yangwei251003/active-inspection/mechanical/CAD_BRIEF.md

# 主动巡检终端 · 机械设计 brief

状态：2026-09-30，采购前可复验设计，未实物试装。单位 mm。模型不用于承重、安全防护或防水认证。

- 新装配：桌面工具风格，深灰底座、浅灰盖、黑色摄像头面罩。180 × 130 × 55 底座，模块化可拆维护。
- 坐标：底座底面中心为原点，XY 为桌面，+Z 向上；正面在 -Y。所有打印零件独立导出，摆放原点在打印底面。
- 壁厚 2.4，底厚 2.4，盖厚 3.0，外圆角 R10；M3 通孔 3.4；螺母窝对边 5.8，装配滑动余量每边 0.35。
- 底座四角螺丝柱，顶盖四颗 M3 × 10 + M3 螺母关闭；不使用热熔铜螺母，不需烙铁。
- 电子托盘 152 × 104，绑带长槽、每板 4 个且合计 8 个 12 mm 高独立 PCB 支脚；NUCLEO 与 P4 并排。板卡孔位不作为已核验设计输入。
- 背部 90 × 18 开口可穿预制 USB/DC 线和舵机可拔电源线，内部绑带孔负责应力释放；背部另有独立舵机服务开口。电气接头选型由硬件清单决定。
- 顶部通用云台托板有可调长槽、绑带槽和排线口。FIT0415 的固定孔位未取得可信尺寸图，因此不会伪造固定孔阵列。
- 摄像头罩用开口后盖、短柱、可调绑带固定 25 × 24 / 32 × 32 摄像板包络；视窗直径 22。镜头轴和传感器板对中需实物核验。
- 支架几何用标注的 55 × 45 × 65 采购件空间包络，不是 FIT0415 的官方 STEP。支架不在打印 BOM。
- 主装配仅安装 1 个线束锚点：15 个打印实体 + 5 个采购参考包络 = 20 个实体。打印清单的第 2 个锚点明确是备用件，不在装配中；打印清单按 15 安装 + 1 备用共 16 件，可选配合试样另计。
- 排线穿顶盖后在头部后方形成宽松 C 环；初次动作仅 ±30° 水平、±15° 俯仰，手动确认无拉扯后再扩大。不得以软件允许角度当作机械通过证据。

## 输入证据与缺口

已检索 step-parts 能力：当前会话未提供；同一 routeId 能力搜索未返回候选。官方板卡资源提供尺寸图/设计文件，但未取得可直接复用的精确 STEP。本次不使用未经核对的社区 STEP。

1. [ST NUCLEO-F401RE 官方资源页](https://www.st.com/en/evaluation-tools/nucleo-f401re.html)：MB1136/UM1724；本模型仅采用 70 × 82.5 × 24 包络，孔位待到货核验。
2. [Waveshare P4-NANO 官方资源](https://docs.waveshare.com/ESP32-P4-NANO/Resources-And-Documents)：尺寸图；本模型采用 85 × 56 × 25 包络，孔位/端口高度未核验。
3. [DFRobot FIT0415](https://www.dfrobot.com/product-1271.html) 与[中文页](https://www.dfrobot.com.cn/exchange-id1117.html)：9–12 g 舵机；组装后高 65。底面包络和安装孔待核验。原厂要求裁剪舵盘，采购应优先卖家预装版本；切勿把裸套件当成完全即插即用。
4. [Waveshare 摄像头系列表](https://www.waveshare.com/rpi-camera.htm)：OV5647 有 25 × 24 与 32 × 32 等不同板型，不能仅按传感器名锁定尺寸。圆孔直径与镜头离面距离待选定 SKU 后验证。

## 输出及验收

- `models/*.step.py`：参数化源；对应 STEP 为主 CAD 交付；`stl/` 是单件打印副本。
- 关闭实体、每件正体积、命名装配；验证外形、底/盖配合、托盘净空和预设采购件包络间隙。
- 对主装配、拆解视图和全部打印件执行 CAD 快照并检查。
- 实板连接器、走线、热、信号完整性、舵机力矩/回差、FFC 疲劳、3D 打印公差和试装均属待实测。
