yangwei251003/active-inspection/mechanical/VISUAL_REVIEW.md

# CAD 快照审看记录

2026-09-30，由负责机械交付的 Codex 子代理实际打开以下 PNG 审看。使用 CAD `scripts/snapshot` 的工程几何输出；没有把图片生成器的概念图作为验证证据。图中矩形电路板、舵机/支架和圆柱镜头是明确标注的采购件参考包络，不能按它们的形状购买、打印或当作已核验实物模型。

| 已审看的文件组（位于 `previews/`） | 实际观察与对应检查 |
|---|---|
| `inspection_terminal_0/1/2/3_20260930T021804Z.png` | 修复后的主装配等轴、背底等轴、顶、前四视图。底盖轮廓对齐，四角孔和顶板布置正常；背后穿线口/底面孔可见，机头朝 -Y。三处接触面由 `check_interfaces.py` 的 0 位移检查支持；主包围盒 180×130×139 mm |
| `exploded_terminal_0_20260930T021804Z.png` | 可看到底座、托盘、两板参考包络、盖和机头的分层关系。爆炸间距是说明性展开，不作为紧固顺序或动态运动证明 |
| `base_shell_0_20260930T020549Z.png` | 腔体、侧通风、背部大窗口、螺母侧槽存在；底座单一实体。大窗口/侧槽的打印支撑待服务商切片确认。后续机头螺柱修复未改变底座几何 |
| `lid_0_20260930T020549Z.png` | 定位环朝上，四角避柱缺口存在；该独立导出已翻为打印朝向，不再手动翻面。后续机头螺柱修复未改变盖几何 |
| `electronics_tray_0_20260930T021423Z.png` | 绑带/轻量化槽、四个固定孔可见，实体连续 |
| `gantry_adapter_0_20260930T021423Z.png` | 纵横长槽和四个底板孔可见，未假定未经核验的 FIT0415 孔距 |
| `camera_shell_0_20260930T021423Z.png` | 四角螺柱向外移后内腔可见，开口未被意外封闭；以实体布尔检查确认 32 mm 板投影加每边 0.4 mm 的区域不与螺柱相交 |
| `camera_back_0_20260930T021423Z.png` | 长槽形成有上部连接桥的安装区域，内横槽保留桥接，未出现悬空小岛；STEP 单实体和 STL 单连通检查支持这一观察 |
| `pcb_foot_0_20260930T021423Z.png` | 12 mm 支脚及中心孔存在，打印底面平整 |
| `cable_anchor_0_20260930T021423Z.png` | 两个绑带槽和中部凸台存在，仍须按线束实物位置粘贴 |
| `fit_coupon_0_20260930T021423Z.png` | 三档圆孔与六角窝可辨，几何尺寸已由对应 STEP facts 及源码参数记录；实际配合待打印 |

审图发现并修复：原机头四角螺柱会挤占最大 32 mm 板的角部。修复前实体相交体积 76.1435 mm³，修复后 0。相机罩/后盖和两份装配 STEP 已重生成，主装配也重新拍摄并审看，未沿用旧主图作为修复后证据。

仍不能由快照判断的事项：具体镜头安装深度、真实 PCB 插头和焊点、FFC 松弛长度/疲劳、实际舵盘连接、云台全行程碰撞、塑料强度、温升、打印公差和孔配合。首测角窗仅为 60–120° / 75–105° 的计划；实际观测记录留在 `fit_check.csv`，未伪填数据。
