yangwei251003/active-inspection/hardware/docs/01-procurement.md

# 模块与器件参考

公开版只保留技术BOM、模块方案和引脚规划，不附个人采购记录、金额、供应商对话或订单。

请查看相邻硬件入口、`../bom.csv`、`../pin-plan.json` 和 `../eda/`。板卡实际修订、接头/线束、供电和机械接口均须结合到货实物核对。本次未采购、接线或烧录，模块图不是制造放行结论。
