yangwei251003/active-inspection/PROVENANCE.md

# 来源与公开范围

来自维护者巡点本地工程。保留自有应用/服务/模拟器/测试、控制与协处理器集成源、参数化机械设计和模块互连设计。原项目截图均明确为模拟来源或模块设计，不冒充实物效果。

本次只在公开副本中整理：将ST依赖清单独立公开、补固定来源获取器、将ESP构建入口改为标准IDF环境调用，泛化本机路径。没有修改原活动服务、SDK、工程或实物，也没有推进新硬件设计。

## 未公开

- SDK、组件/工具缓存、node_modules、编译输出、GLTF生成缓存、备份和运行日志。
- 当前 `sdkconfig`、真实服务配置、`.env`、Wi-Fi、密码、设备令牌与私有数据目录。
- 个人预算/询价、事件账本、原始状态、真实部署数据和历史媒体工具产物。
- 官方EDA对照项目及其他厂商参考材料；这些不是独立原创项目。

技术BOM剔除了估算价格字段。SDK与C6官方从机不计作本项目原创代码。由于开发中和上述公开边界，不能据本仓库宣称整个原本地文件夹均已托管或可删除。

最终文档复查额外排除厂商参考 PDF/裁图及个人采购金额；修复旧机器浏览链接，并把可选 Playwright/CAD 工具入口改为通用依赖或明确环境变量。原工程历史检查说明不作为本次实测证据。
