yangwei251003/active-inspection/mechanical/fit_check.csv

检查ID | 检查对象 | 设计值或判据 | 实测值 | 单位 | 结果 | 照片或日志路径 | 备注
M01 | NUCLEO板卡含接头包络 | 不超70×82.5×24 |  | mm | 待测 |  | 先确认型号和板版本
M02 | P4板卡含接头包络 | 不超56×85×25 |  | mm | 待测 |  | 先确认型号和板版本
M03 | 相机PCB和镜头中心 | 所选SKU可放入罩内且镜头对中 |  | mm | 待测 |  | 不得只按OV5647传感器名确认尺寸
M04 | 成品云台采购状态 | 两舵机和匹配舵盘已装好且无需裁剪 |  |  | 待测 |  | 裸FIT0415不满足本项
M05 | M3配合试样中间通孔 | 标称3.4且螺丝可手放入 |  | mm | 待测 |  | 不要整件缩放
M06 | M3配合试样中间六角窝 | 标称对边5.8且螺母可平放 |  | mm | 待测 |  | 本试样不代表侧装槽已通过
M07 | 底座侧装螺母槽 | 4处螺母能进入定位且无明显摇晃 |  |  | 待测 |  | 手动检验
M08 | 上盖定位环 | 每边设计余量0.35且无强压装配 |  | mm | 待测 |  | 记录打印材料和切片参数
M09 | 底部螺丝头离桌面 | 至少1 |  | mm | 待测 |  | 5mm脚垫名义值仍须按螺丝头实测
M10 | 托盘螺丝方向 | 从底座外底面向上穿入且顶端不触板 |  |  | 待测 |  | 4处分别确认
M11 | 两块板卡固定 | 轻摇不移位且绑带不压器件和插座 |  |  | 待测 |  | 支脚位置按板底避空区布置
M12 | 板上器件线材与上盖 | 不接触或挤压且有可见余量 |  | mm | 待测 |  | 设计板包络到盖平面最小4.2
M13 | USB和电源线应力释放 | 轻拉外皮时板卡插座不移动 |  |  | 待测 |  | 不得拉FFC或裸端子
M14 | 中位镜头画面 | 四角无罩体遮挡且画面可用 |  |  | 待测 |  | 保存90/90画面
M15 | 水平60俯仰75 | 无碰撞拉扯遮挡和异常声音 |  |  | 待测 |  | 仅在电气核验和限角配置完成后点动
M16 | 水平60俯仰105 | 无碰撞拉扯遮挡和异常声音 |  |  | 待测 |  | 同上
M17 | 水平120俯仰75 | 无碰撞拉扯遮挡和异常声音 |  |  | 待测 |  | 同上
M18 | 水平120俯仰105 | 无碰撞拉扯遮挡和异常声音 |  |  | 待测 |  | 同上
M19 | 限角窗内重复巡检 | 线缆无磨损松脱且视点可重复 |  |  | 待测 |  | 记录次数和画面偏移
M20 | 封闭运行温升 | 记录环境与壳内温度及复位抖动 |  |  | 待测 |  | 无实测前不填写通过
