yangwei251003/active-inspection/docs/images/mobile-points.png

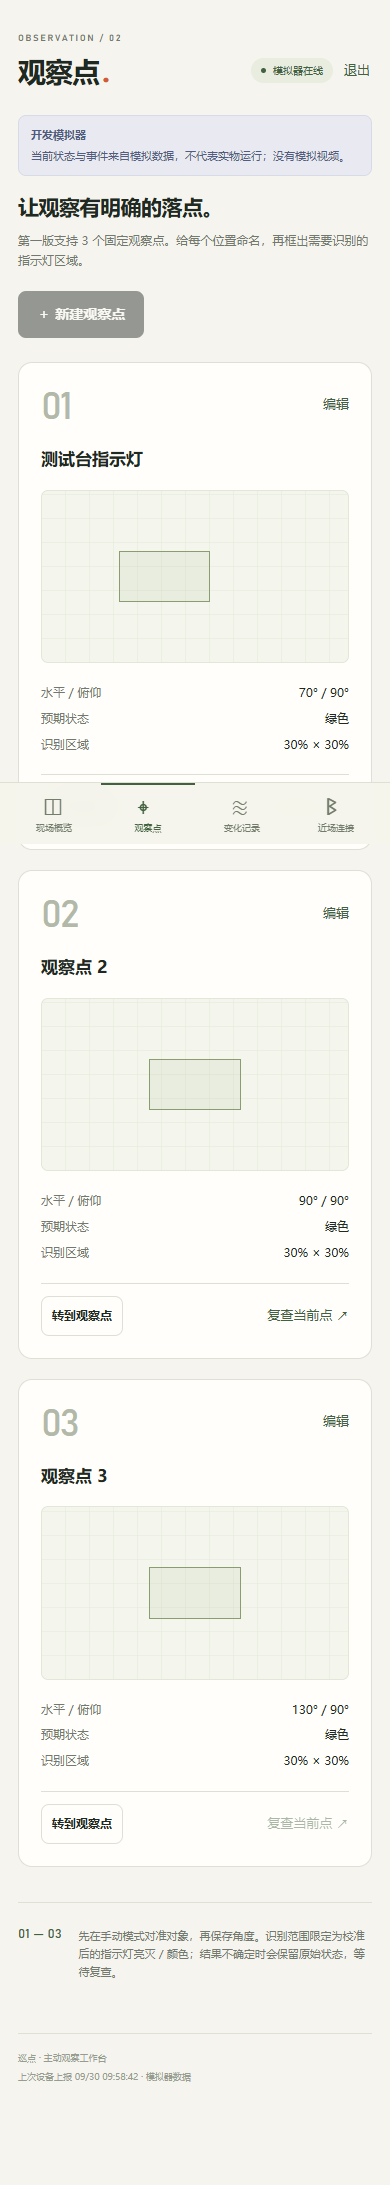
docs/images/mobile-points.png
