yangwei251003/active-inspection/hardware/eda/module-interconnect.png

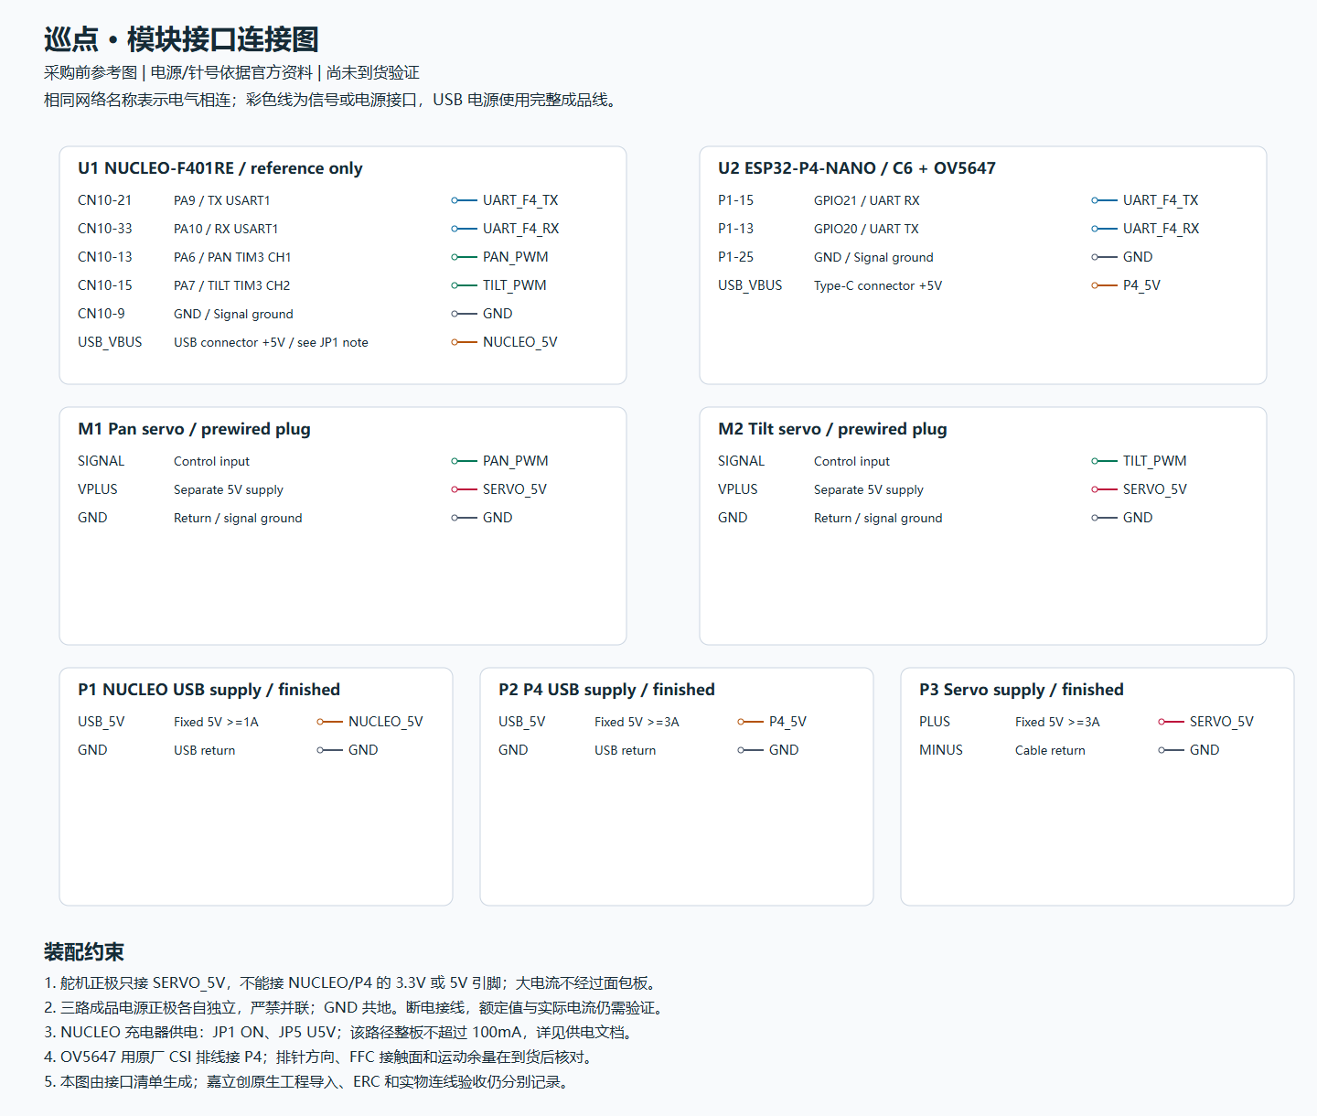
hardware/eda/module-interconnect.png
