yangwei251003/active-inspection/mechanical/previews/base_shell_0_20260930T020549Z.png

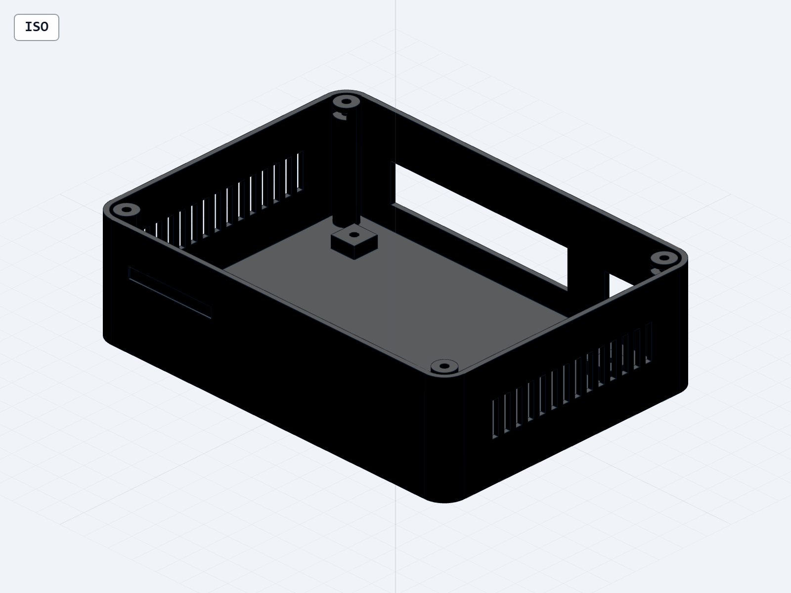
mechanical/previews/base_shell_0_20260930T020549Z.png
