yangwei251003/active-inspection/mechanical/previews/cable_anchor_0_20260930T021423Z.png

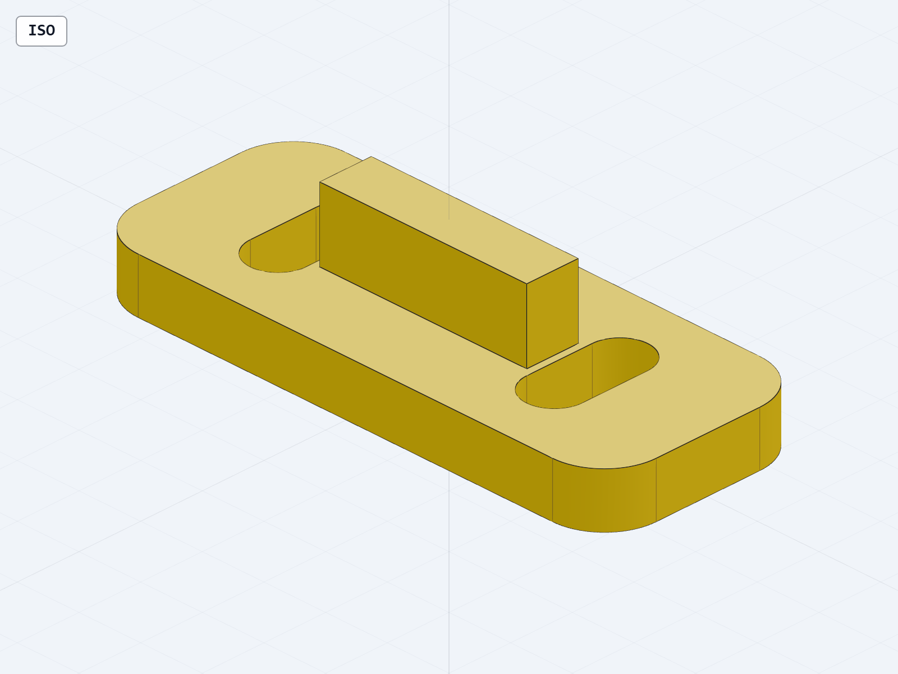
mechanical/previews/cable_anchor_0_20260930T021423Z.png
