yangwei251003/active-inspection/mechanical/previews/camera_shell_0_20260930T021423Z.png

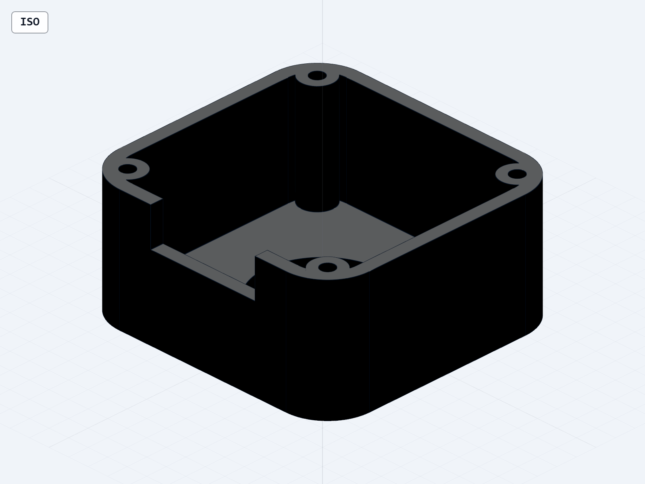
mechanical/previews/camera_shell_0_20260930T021423Z.png
