yangwei251003/active-inspection/mechanical/previews/electronics_tray_0_20260930T021423Z.png

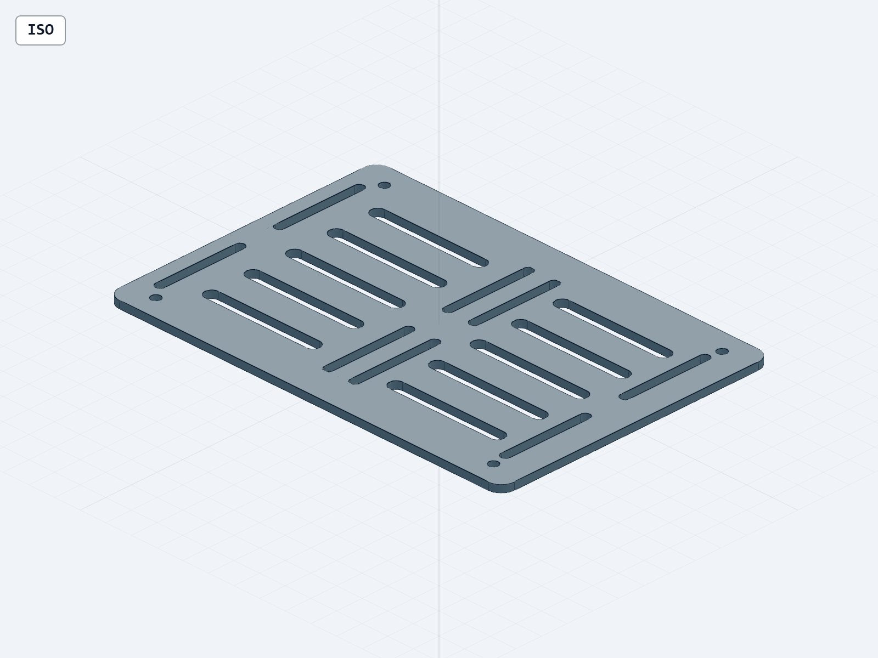
mechanical/previews/electronics_tray_0_20260930T021423Z.png
