yangwei251003/active-inspection/mechanical/previews/exploded_terminal_0_20260930T020549Z.png

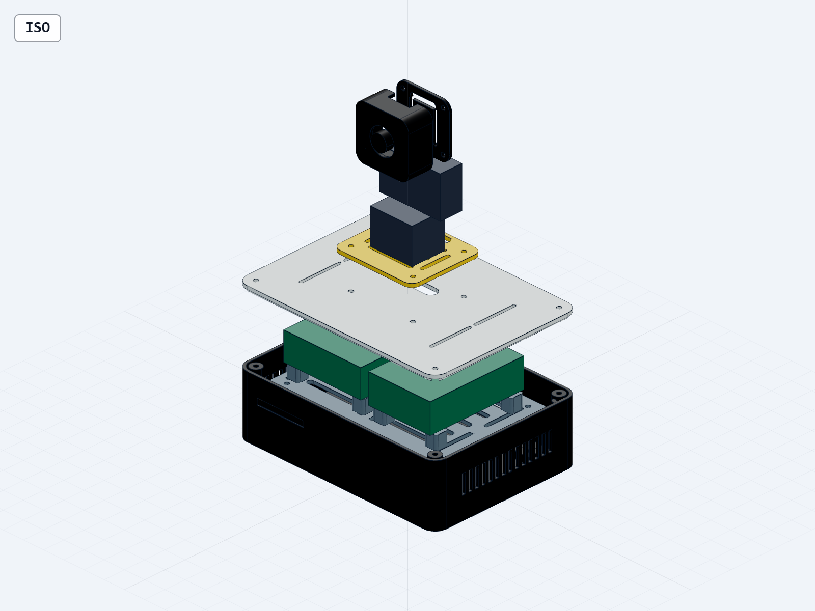
mechanical/previews/exploded_terminal_0_20260930T020549Z.png
