yangwei251003/active-inspection/mechanical/previews/fit_coupon_0_20260930T021423Z.png

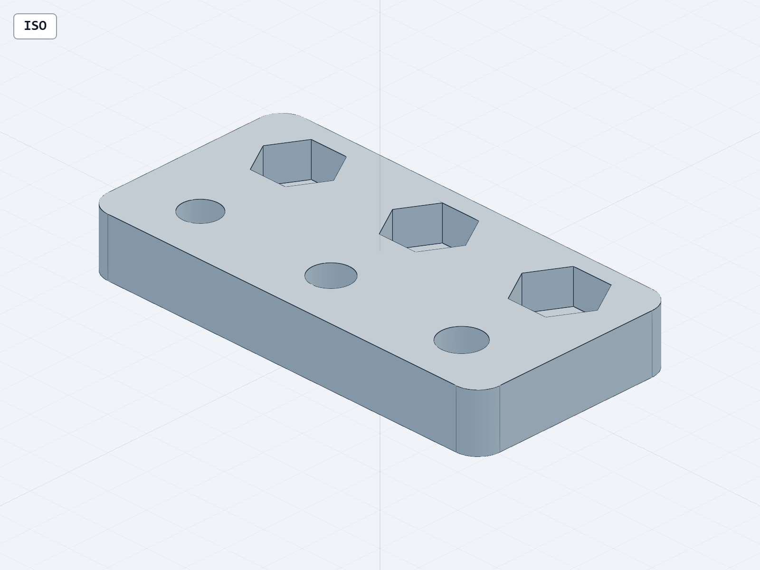
mechanical/previews/fit_coupon_0_20260930T021423Z.png
