yangwei251003/active-inspection/mechanical/previews/initial_iso_20260930T014438Z.png

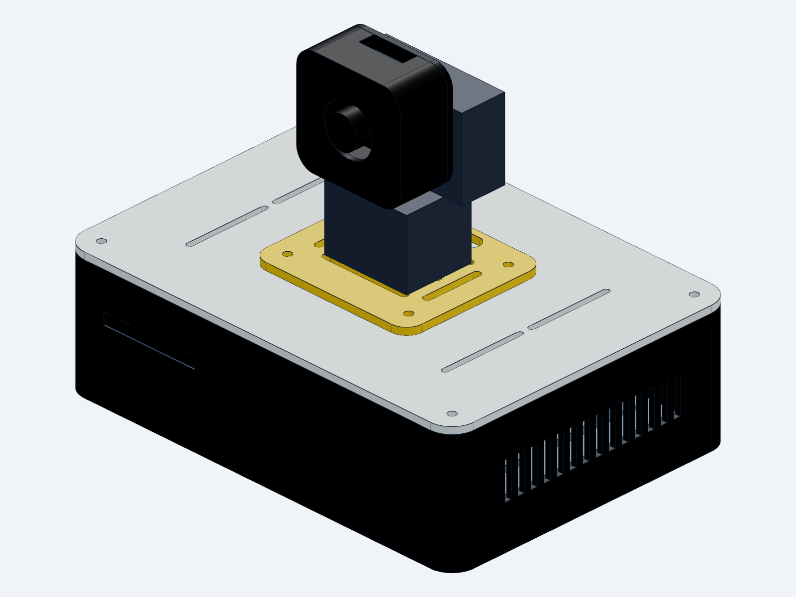
mechanical/previews/initial_iso_20260930T014438Z.png
