yangwei251003/active-inspection/mechanical/previews/inspection_terminal_1_20260930T020549Z.png

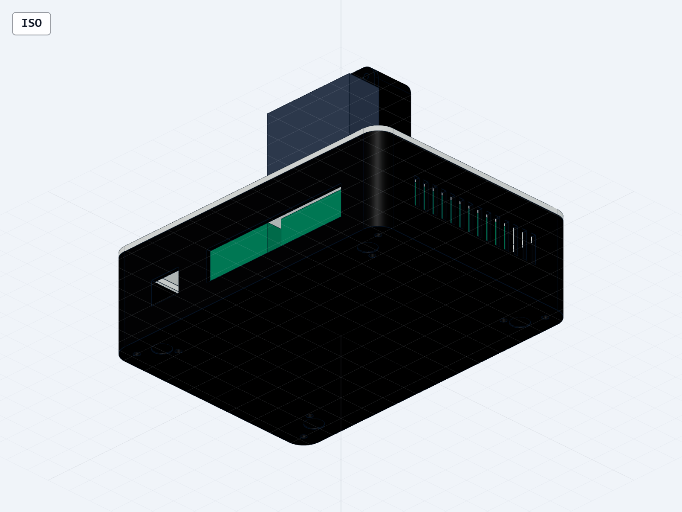
mechanical/previews/inspection_terminal_1_20260930T020549Z.png
