yangwei251003/active-inspection/mechanical/previews/lid_0_20260930T020549Z.png

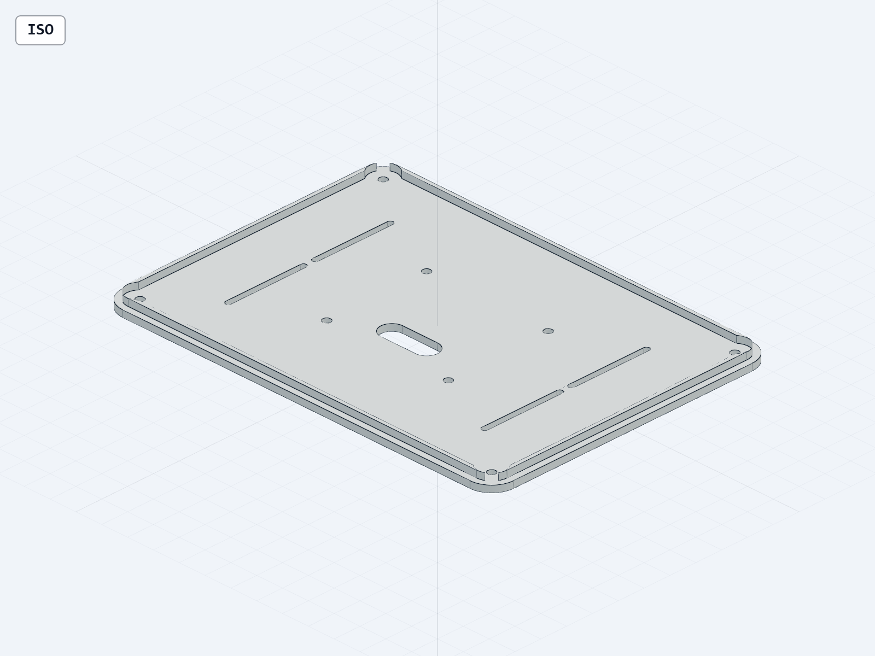
mechanical/previews/lid_0_20260930T020549Z.png
