yangwei251003/active-inspection/mechanical/previews/pcb_foot_0_20260930T021423Z.png

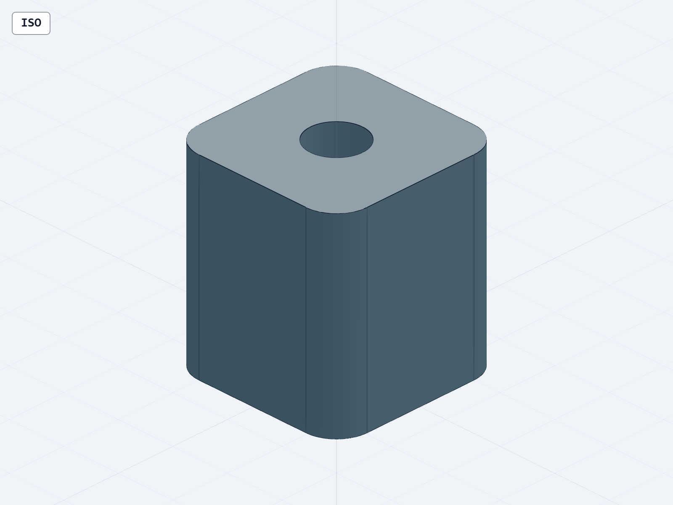
mechanical/previews/pcb_foot_0_20260930T021423Z.png
