yangwei251003/active-inspection/mechanical/models/cable_anchor.step

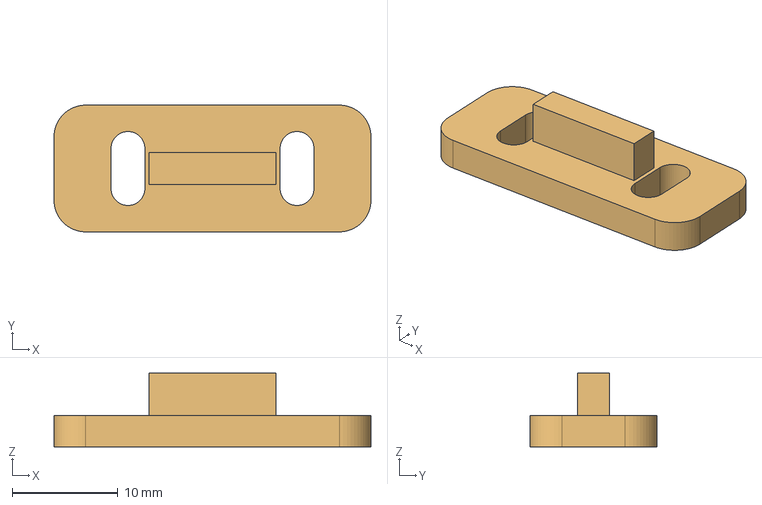
[picture p19: CAD file, 2026-10-27]
mechanical/models/cable_anchor.step
30.0 x 12.0 x 7.00 mm
