yangwei251003/active-inspection/mechanical/models/electronics_tray.step

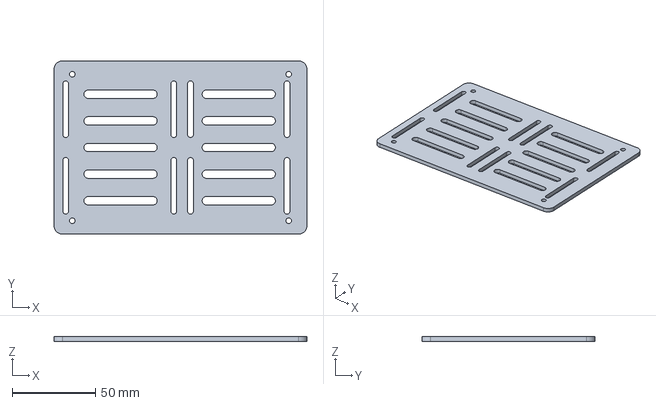
[picture p20: CAD file, 2026-10-27]
mechanical/models/electronics_tray.step
152.0 x 104.0 x 2.80 mm
