yangwei251003/active-inspection/mechanical/models/base_shell.step

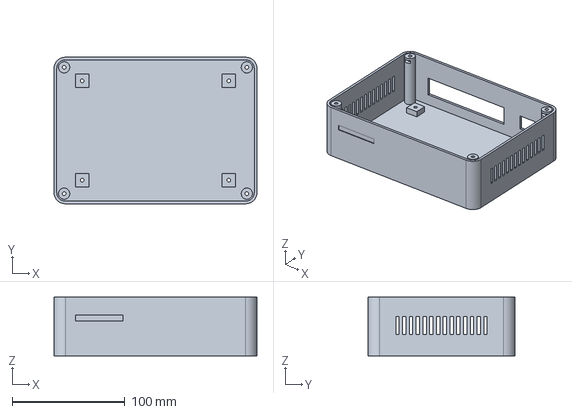
[picture p21: CAD file, 2026-10-27]
mechanical/models/base_shell.step
180.0 x 130.0 x 52.0 mm
