yangwei251003/active-inspection/mechanical/models/pcb_foot.step

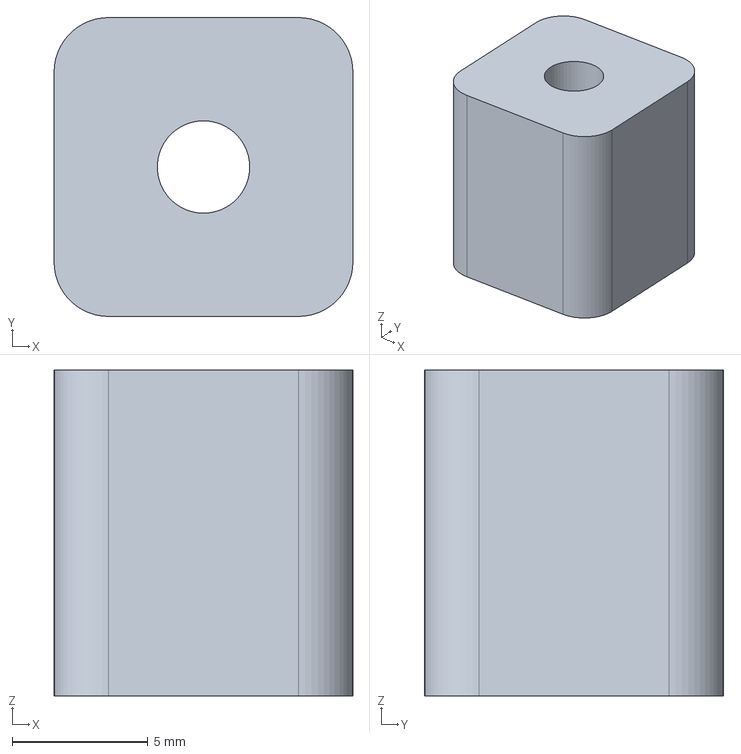
[picture p22: CAD file, 2026-10-27]
mechanical/models/pcb_foot.step
11.0 x 11.0 x 12.0 mm
