yangwei251003/active-inspection/mechanical/models/camera_back.step

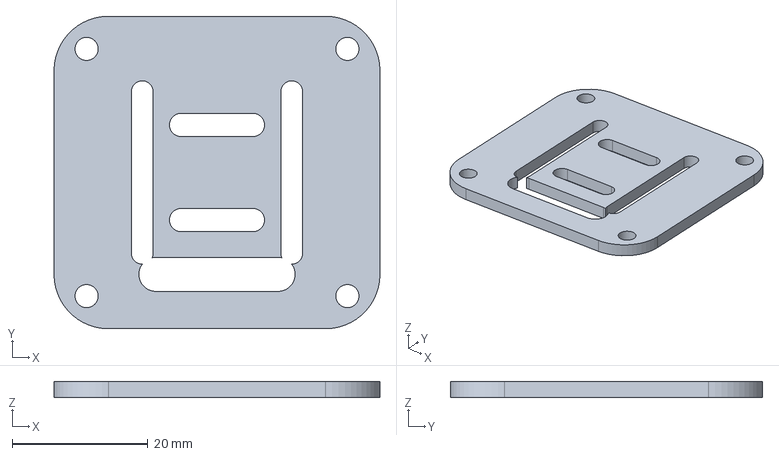
[picture p23: CAD file, 2026-10-27]
mechanical/models/camera_back.step
48.0 x 46.0 x 2.40 mm
