yangwei251003/active-inspection/mechanical/models/fit_coupon.step

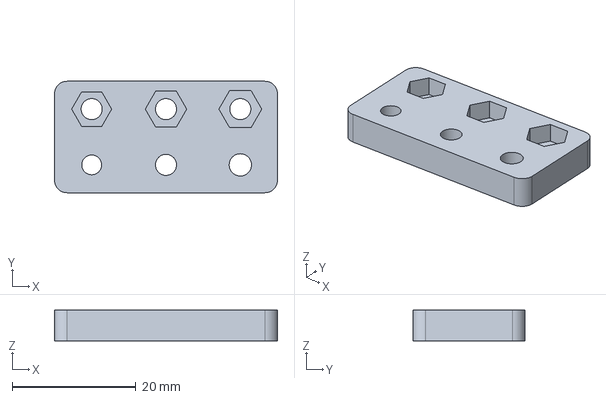
[picture p24: CAD file, 2026-10-27]
mechanical/models/fit_coupon.step
36.0 x 18.0 x 5.00 mm
