yangwei251003/active-inspection/mechanical/models/lid.step

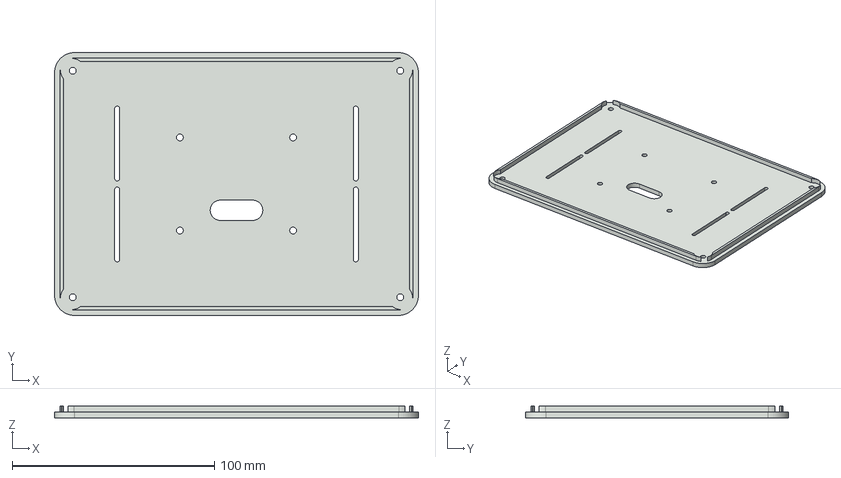
[picture p26: CAD file, 2026-10-27]
mechanical/models/lid.step
180.0 x 130.0 x 6.00 mm
