yangwei251003/active-inspection/mechanical/models/inspection_terminal.step

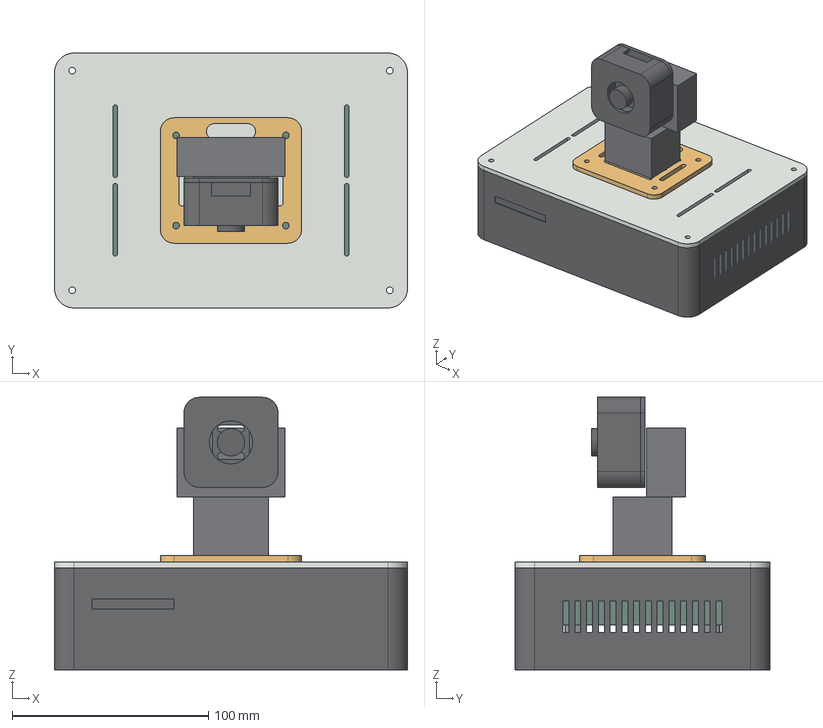
[picture p27: CAD file, 2026-10-27]
mechanical/models/inspection_terminal.step
180.0 x 130.0 x 139.0 mm
base_shell
lid_with_locating_rim
adjustable_electronics_tray
universal_pan_tilt_adapter
camera_front_shell
camera_back_adjustable_mount
pcb_foot_1
pcb_foot_2
pcb_foot_3
pcb_foot_4
pcb_foot_5
pcb_foot_6
pcb_foot_7
pcb_foot_8
cable_tie_anchor
REFERENCE_NUCLEO_F401RE_ENVELOPE
REFERENCE_P4_NANO_ENVELOPE
REFERENCE_PAN_SERVO_ENVELOPE
REFERENCE_TILT_BRACKET_ENVELOPE
REFERENCE_LENS_ENVELOPE
