yangwei251003/active-inspection/mechanical/models/gantry_adapter.step

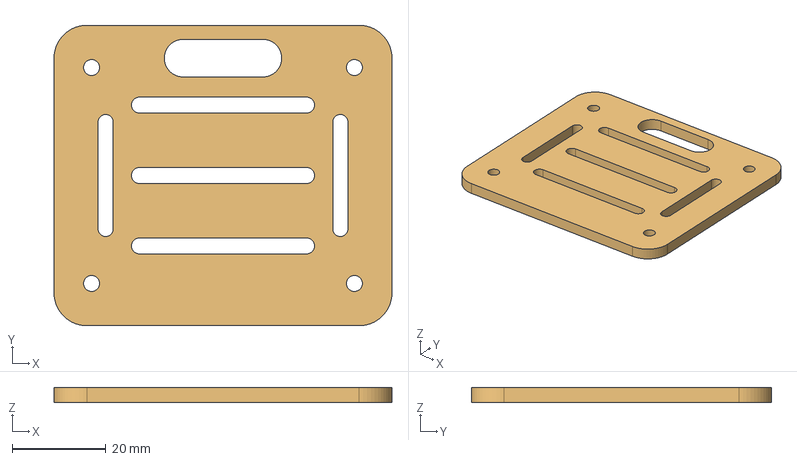
[picture p28: CAD file, 2026-10-27]
mechanical/models/gantry_adapter.step
72.0 x 64.0 x 3.20 mm
