yangwei251003/active-inspection/mechanical/models/camera_shell.step

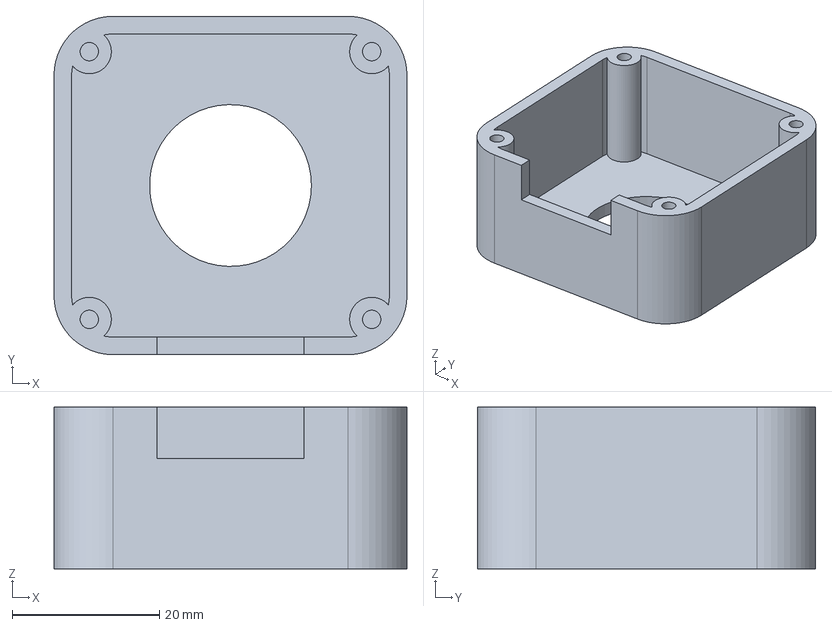
[picture p29: CAD file, 2026-10-27]
mechanical/models/camera_shell.step
48.0 x 46.0 x 22.0 mm
