yangwei251003/active-inspection/(list of files, cad)

Other CAD files:
mechanical/inspection_terminal.FCStd
mechanical/stl/base_shell.stl
mechanical/stl/cable_anchor.stl
mechanical/stl/camera_back.stl
mechanical/stl/camera_shell.stl
mechanical/stl/electronics_tray.stl
mechanical/stl/fit_coupon.stl
mechanical/stl/gantry_adapter.stl
mechanical/stl/lid.stl
mechanical/stl/pcb_foot.stl
