yangwei251003/active-inspection/mechanical/PRINT_REQUEST.md

# 结构件审阅与试配

本公开版不包含个人报价或下单说明。自有模型位于 `models/`、网格位于 `stl/`，其尺寸与接口意图应同CAD源和BRIEF核对。

当前未打印、试装或验证负载强度。先在确认实际板卡、成品云台、插头与FFC后做小件试配，再决定是否打印完整外壳；不得仅凭数字模型宣称装配或打印质量通过。

材料、打印方向和容差需要针对使用者自己的设备与工艺验证。本项目不自动下单或提供制造放行。
