yangwei251003/active-inspection/hardware/docs/03-arrival-and-assembly.md

# 到货核验与一步一验证

本流程用于材料到货后。当前没有实物照片或连接证据，表中“预期现象”均为目标，不代表已发生。首次动作由固件/硬件交付人按确认后的板号提供对应包；不要求用户自行选择编译目标或查芯片手册。

## 到货材料登记

| 对象 | 用户只需提供/确认 | 由工程侧完成的核验 | 不通过时 |
|---|---|---|---|
| NUCLEO | 包装标签、正反面清晰照片、MCU 丝印、跳帽照片 | NUCLEO-F401RE、MB1136 修订、F401RET6、Mini-B、排针号、ST-LINK 区完整 | 暂不接外设；纠正型号或退换，不能照旧烧录 |
| P4 KIT-A | 包装 SKU、两面 PCB、P4/C6 模块字样、GPIO 排针近照 | 经典 C6 版、预焊 P1/P2、PCB/芯片修订、GPIO20/21 物理端子，固件目标最低修订 | 不用强制忽略芯片版本烧录；换匹配固件/合适版本 |
| 相机与 FFC | 摄像头背面标签、排线两端、长度/插座照片 | OV5647/RPi Camera (B)、配套 15PIN、触点方向、CSI 座、镜头/板尺寸 | 不以任意树莓派摄像头替代；使用确认配套件 |
| 云台 | 卖家预装后的正侧面、三线插头、舵机型号 | 两轴已装妥、无用户裁剪舵盘任务、线序、3.3 V 信号支持、与托板固定方式 | 卖家处理或更换成品，不交给用户临时钻孔/裁剪 |
| 电源/分线 | 三个适配器输出铭牌、连接器和分线板近照 | 固定 5 V、正确电流能力/插头、没有需要焊接的部件、三路正极独立 | 错标/缺资料/裸 PCB 不接电 |
| 工具与打印 | 万用表/USB 表可开机；打印报价与 CAD 文件版本 | 本次物料总价；几何版本与到货包络、孔距及插拔空间一致 | 尺寸不一致先改模型，不强压板卡或现场削外壳 |

电子记录至少包含：物料 ID、型号、商家/订单号（私人保存）、PCB 修订、收到日期、照片路径、预焊/预装证据、核验人、结论和适配固件哈希。工程状态依次区分 planned / ordered / received / verified；本包目前只有 planned。

## 分步搭建卡

每步通过后再做下一步。改变接线之前拔掉三个低压电源；所有测量只在 5 V/3.3 V 侧进行。手机充电器内部不拆开，插座市电侧不测量。

| 步骤 | 只做这一件事 | 必须看到/记录 | 没看到时 |
|---|---|---|---|
| 1 | 全部断电，把两块板和预装云台摆在绝缘桌垫上；核对登记表 | 板型和版本已有匹配结论；没有松落螺钉压在板底 | 先补照片/换件，不继续供电 |
| 2 | 仅用确认数据线将 NUCLEO 接 PC，舵机和 P4 均不连接 | 系统能识别 ST-LINK，目标供电指示正常；记录设备标识 | 换确认的数据线/USB 口；不要先改启动引脚或焊桥 |
| 3 | 使用板号匹配、哈希明确、**舵机输出禁用**的参考固件走独立烧录步骤 | 烧录工具成功记录与固件版本；板级心跳/日志符合固件说明 | 停在这一块板排查；“编译成功”不能替代本步骤 |
| 4 | 单独给 P4 Type-C 上电，并按匹配修订固件说明检查启动 | 识别到正确 P4/C6 和固件；没有反复复位/异常发热 | 不接相机和舵机扩大问题；保存完整启动日志 |
| 5 | 全断电，按工程标注照片装入 CSI FFC，只保留 P4 支路上电 | 本地连续图像稳定，摄像头型号被正确识别 | 先断电再查 FFC 方向/锁扣/型号，不带电翻插 |
| 6 | 全断电，按最终针图接两板 GND、TX/RX，仍不接舵机供电 | 上电后两个方向均有协议确认；控制器在线、CRC/序号正常 | 使用故障表核对 TX/RX 和针 1 方向；不要随机换线 |
| 7 | 用固定 5 V USB 电源替换 PC 电源，核对 NUCLEO JP1/JP5 模式并记录电流 | PC 拔掉后两板仍运行，启动和稳定工作电流符合路径限制 | 查 NUCLEO 无 USB 枚举问题；不把“USB 灯亮”当目标 MCU 已运行 |
| 8 | 断开云台信号与电机，单独量分线模块 V+ 对 GND | 约 5 V、极性正确，电源规格与批准表一致 | 如不在所用元件规格范围或极性反向，断电改正；不要插电机试探 |
| 9 | 全断电，接一只舵机信号和独立 5 V；镜头/FFC 不随动、云台周围无障碍；加载核验后的限幅输出配置 | 中位及±5°小步运动可控，不啸叫/卡滞/导致板复位；记录电压和方向 | 立即切断舵机支路；检查线序、信号门限和机械卡滞 |
| 10 | 按同法验证另一只，仍分别运动 | 两轴名称和方向一致，断网/暂停后不继续接收旧运动 | 方向不符由工程修改配置，不要求用户推导角度 |
| 11 | 固定摄像头，整理 FFC 余量，先无电检查路线，再小步扩大窗口 | 在限定窗口无夹线/扯线；画面没有因运动反复掉线 | 收紧角度、更改支架/排线；不直接将全 180°作为工作窗口 |
| 12 | 固定预置点 A/B，执行往返和停止测试 | 能看到目标，状态“不确定”可正常出现，不将误判隐藏 | 重选光照/ROI/距离，保留失败图像用于算法修改 |
| 13 | 按软件部署文档完成局域网、手机蜂窝网络、PC 异地网络、近场 BLE 分项测试 | 每项分别记录设备/网络/延迟/断流；模拟标识与实物标识不混用 | LAN 通过只记 LAN；BLE 不承载异地网络，也不承载视频 |
| 14 | 电路通过后按机械装配表装壳，保留通风/天线与 FFC 空间 | 各接口仍可插拔，无板底金属接触、无拉紧线束；装壳前后视频/BLE均可用 | 先修改支撑/走线，不能用外壳把线硬压进板卡 |
| 15 | 连续独立运行 2 小时并做一次断网恢复 | 记录重启、帧率、误报、不确定样本、电源读数；恢复后不重放旧运动 | 按日志修正软件或电源，再重复受影响项 |

第 3/4 步的实际烧录需绑定实物身份和最终包，当前没有代替用户烧录。第 9 步默认镜像会拒绝运动，这是设计行为；不能用远程命令绕过输出禁用来“测试一下”。

## 面包板与装配示意原则

两块开发板分别放在绝缘托盘，不把 NUCLEO 整板硬插进小面包板。面包板可以承接信号测试点和低电流共地点；只有在最后针图明确了每条线以后才插线。舵机端子板、两个舵机插头和大电流正负线布置在面包板外侧，线号分别标 `PAN_S`、`TILT_S`、`SERVO_5V`、`GND`。UART 使用 `F4_TX_TO_P4_RX` 和 `P4_TX_TO_F4_RX`，避免两端都写 TX 引起混淆。

成品外壳应先打印小型孔位/FFC 过线验证件或用纸板/纸张轮廓核尺寸，再打印主体；若打印报价只有一次整壳预算，要先用到货尺寸修改 CAD，减少重打。采用可拆装螺钉、绑带和软垫，不需要胶封或烙铁。
