yangwei251003/active-inspection/mechanical/VERIFICATION.md

> 原阶段数字检查记录：本次公开副本仅重新验证README列出的软件/编译部分；未打印、试装或实测硬件。财务段落不公开。

# 机械数字交付核验

核验日期：2026-09-30。范围是采购前参数化结构、导出文件和数字几何。没有打印/实物试装/运动/温升结果，不可据此直接宣称成品验收通过。

| 检查 | 结果与证据 |
|---|---|
| 参数化源与导出 | 主源 `models/inspection_geometry.py`，11 个显式生成目标的 STEP；`evidence/*_validate.json` 为 CAD 工具实际检查结果，所有目标 `failureCount=0` |
| 装配外形 | 180×130×139 mm，不含胶粘脚垫；主装配含 20 个实体，其中 5 个是采购件参考包络 |
| 装配打印件 | 8 种零件，实际安装 15 件；加 1 个备用线束锚点，建议打印共 16 件。主装配 20 实体 = 15 打印件 + 5 采购参考包络，备用件不在装配内。每种 STEP 为单一有效正体积实体；源/导出包围盒与体积相符，见 `design_validation.json` |
| 相机后盖 | 单一实体，真实 STL 单连通；没有先前槽切割产生的悬空岛 |
| 底座—盖、托盘—座垫、盖—云台托板 | CAD 面配合位移均为 0；见 `base_lid_flush.json`、`tray_seat_flush.json`、`lid_gantry_flush.json` |
| 底座/盖/托盘 | 三对实体相交体积均为 0，接触面由上述面配合检查确认 |
| 板卡参考间距 | 两板中心 X 距 71 mm，按各自包围盒得到 X 净距 8 mm；参考板最高点 Z=47.8，到盖平面余量 4.2 mm。这只覆盖已建参考包络，不覆盖实际线材 |
| 相机板角部修复 | 螺柱/盖孔由 ±18.2、±17.2 改为 ±19.2、±18.2；32 mm 板投影每边额外留 0.4 后，检查区交叠从 76.1435 mm³ 变为 0，见 `camera_clearance_before.json` / `camera_clearance_after.json` |
| 打印网格 | 9 个 STL（含可选试配件）均闭合、单连通、绕序一致、正体积，且最低 Z=0；见 `stl_validation.json`。不等于切片或打印通过 |
| FreeCAD 原生文件 | FreeCAD 1.1.3 导入最终 STEP，生成 20 个可单独选择的命名实体，保存 `inspection_terminal.FCStd` 后重开，全部有效。STEP/源/FCStd 的 SHA-256 在 `freecad_import.json` 中。该文件不是原生草图特征树，参数化主源仍为 Python |
| 视觉复核 | 保存的 CAD 快照及人工审看说明见 `VISUAL_REVIEW.md`，不使用概念渲染代替工程几何 |
| 浏览交接 | 旧机器浏览服务与证据日志不随公开版分发；请用本地 CAD 软件打开归档模型 |

本次既没有修改学习记录，也没有写入项目验收状态。上述 JSON 为机械工件证据，不能替代项目整体的软件、通信和实物测试。

未验证项：真实 NUCLEO/P4 板版本及接头高度、预装云台孔位与舵盘、相机具体 SKU 的镜头位置/PCB厚度/FFC、动态扫掠净空、限角点动、耐久与回差、热、塑料强度和打印装配公差。首次实物仅验证水平 60–120°、俯仰 75–105°；这些是指令角窗，不代表整个范围已通过运动验证。
