yangwei251003/active-inspection/VALIDATION.md

# 本次公开副本验证

日期：2026-10-26。Windows，Node.js 24.15.0，主机GCC6.3，Arm GCC14.3.1。

| 部分 | 本次实际执行 |
|---|---|
| Node服务 | 19/19现有测试通过，覆盖会话/来源/CSRF、命令、持久化、WebSocket、媒体代理和证据等 |
| 网页 | 27/27现有测试通过，覆盖客户端、蓝牙协议、状态来源、ROI、CSV和WHEP等 |
| STM32主机核 | 24组现有行为/协议测试通过 |
| ST依赖 | 从固定官方档案/文件重建并校验323个清单文件，本地校验均匹配 |
| F401RE候选 | 真正离线编译、链接和BIN生成通过；Flash10844B，RAM4776B（含预留区）；舵机输出默认禁用 |
| 独立协处理器核心 | 真正GCC编译并运行已有CRC、黄金帧、ROI、边界、重放/TTL等断言检查，通过 |
| 现有打印网格 | 9个既有STL的封闭性、连通性、绕序、体积方向和底面检查通过；未切片、打印或试装 |
| 既有STEP与参数源 | 8种打印零件的有效实体、源/导出尺寸及体积一致性通过；3组装配交叠和相机板投影避空检查通过。仅重读并计算现有设计，未修改或重新生成模型 |

可选浏览器检查与示意图渲染入口已改为普通 Playwright 包或显式 `PLAYWRIGHT_PACKAGE`；4个相关脚本语法检查通过。机械辅助工具可通过 `CAD_SKILL_PATH` 指定外部CAD Skill，其源码不捆绑；4个相关Python脚本语法检查通过。此次未运行可选浏览器端到端检查、CAD生成或FreeCAD导入。

未启动EDA/Bridge、未改原工程、SDK或服务、未接线/烧录/操作实板。真实相机、无线、蓝牙、云台、视频、功耗和结构配合仍未在此次公开副本验证。

完整P4/C6固件与生产媒体服务未在本次迁移重建，不能将原阶段构建记录改为本公开副本已通过。Pages静态预览与真实Node后端分别说明，不把未部署服务称为在线。

生成日志、编译产物、临时数据和依赖均被忽略。发布前源码清单、文档/容器/元数据隐私检查与秘密扫描结果保存在迁移报告中。
