yangwei251003/active-inspection/CHANGELOG.md

# 更新日志

## 0.1.0 — 2026-10-26

- 整理巡点已有软件、固件集成、机械与模块互连设计。
- 剔除真实配置、令牌、数据、采购金额、缓存、SDK和构建产物。
- 增加固定ST依赖获取与校验，公开ESP标准环境构建入口并保留未复现范围。
- 补充真实原项目配图、本地模拟指南、静态预览与验证记录。
- 厂商资料只保留官方入口；清理旧机器链接，明确可选CAD/Playwright依赖；复核现有STEP与9个STL。

## 后续规划

- 在实际目标环境复现P4/C6完整构建与媒体服务闭环。
- 到货核对板卡、接线和机械配合后再逐步烧录/实测。
- 实测相机、无线、伺服方向/脉宽、限位和定位重复性；当前不填虚构结果。
