yangwei251003/active-inspection/hardware/eda/module-interconnect.pdf

# 巡点 · 模块接口连接图

### U1 NUCLEO-F401RE / reference only

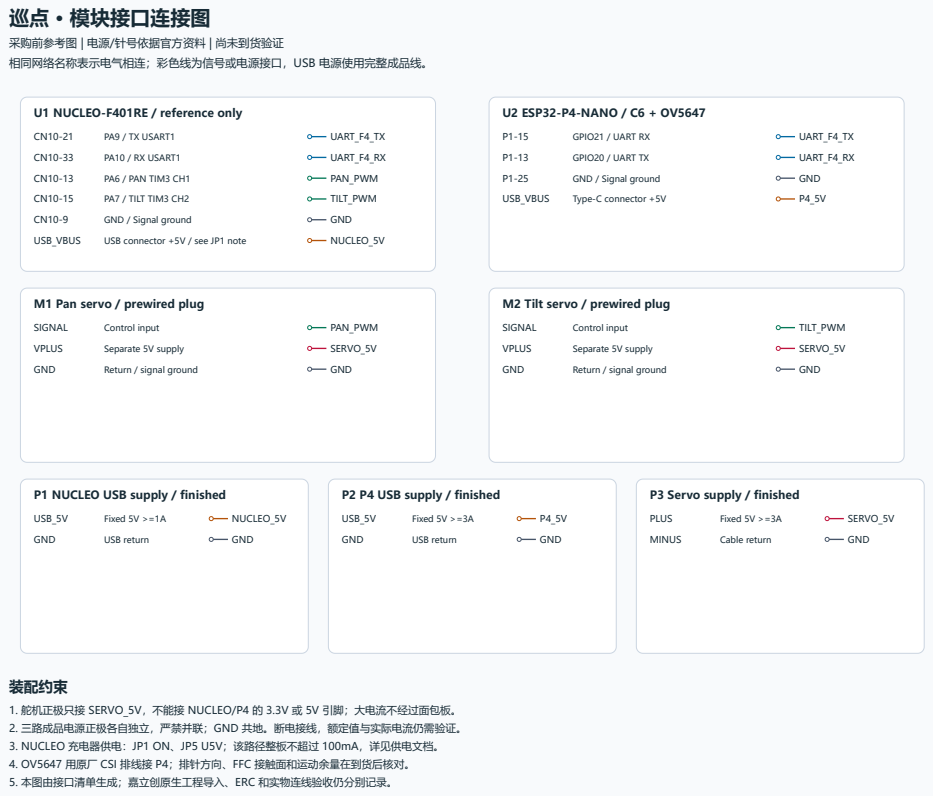
[picture p30: page 1]
PA9 / TX USART1; UART_F4_TX; PA10 / RX USART1; UART_F4_RX; PA6 / PAN TIM3 CH1; PAN_PWM; PA7 / TILT TIM3 CH2; TILT_PWM; GND / Signal ground; GND; USB_VBUS; USB connector +5V / see JP1 note; NUCLEO_5V; U2 ESP32-P4-NANO / C6 + OV5647; GPIO21 / UART RX; GPIO20 / UART TX; Type-C connector +5V; SIGNAL; Control input; VPLUS; Separate 5V supply; SERVO_5V; Return / signal ground; USB_5V; Fixed 5V >=1A; USB return; Fixed 5V >=3A; PLUS; MINUS; Cable return; 装配约束

采购前参考图 | 电源/针号依据官方资料 | 尚未到货验证
相同网络名称表示电气相连；彩色线为信号或电源接口，USB 电源使用完整成品线。

M1 Pan servo / prewired plug

M2 Tilt servo / prewired plug

P1 NUCLEO USB supply / finished

P2 P4 USB supply / finished

P3 Servo supply / finished

1. 舵机正极只接 SERVO_5V，不能接 NUCLEO/P4 的 3.3V 或 5V 引脚；大电流不经过面包板。
2. 三路成品电源正极各自独立，严禁并联；GND 共地。断电接线，额定值与实际电流仍需验证。
3. NUCLEO 充电器供电：JP1 ON、JP5 U5V；该路径整板不超过 100mA，详见供电文档。
4. OV5647 用原厂 CSI 排线接 P4；排针方向、FFC 接触面和运动余量在到货后核对。
5. 本图由接口清单生成；嘉立创原生工程导入、ERC 和实物连线验收仍分别记录。
